CaioPegoraro/ProjetoFinalMic/schematics/schematics.txt

== Emissor primario
https://github.com/CaioPegoraro/ProjetoFinalMic/blob/master/schematics/emissor_primario.png

(20/01/2017)
- Adicionado ligações do emissor primário

== Receptor primário 
https://github.com/CaioPegoraro/ProjetoFinalMic/blob/master/schematics/receptor_primario.PNG

(20/01/2017)
- Adicionado ligações do receptor primário

== Receptor secundário
https://github.com/CaioPegoraro/ProjetoFinalMic/blob/master/schematics/receptor_secundario2.png

(01/02/2017)
- Adicionado esquemático inicial do receptor secundário

(09/02/2017)
- Esquemático do receptor secundário atualizado
