CaioPegoraro/ProjetoFinalMic/imagens/Capture.PNG

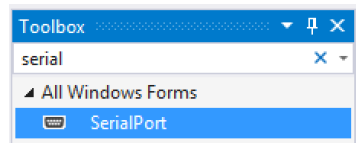
imagens/Capture.PNG
