CaioPegoraro/ProjetoFinalMic/imagens/Rover 2.JPG

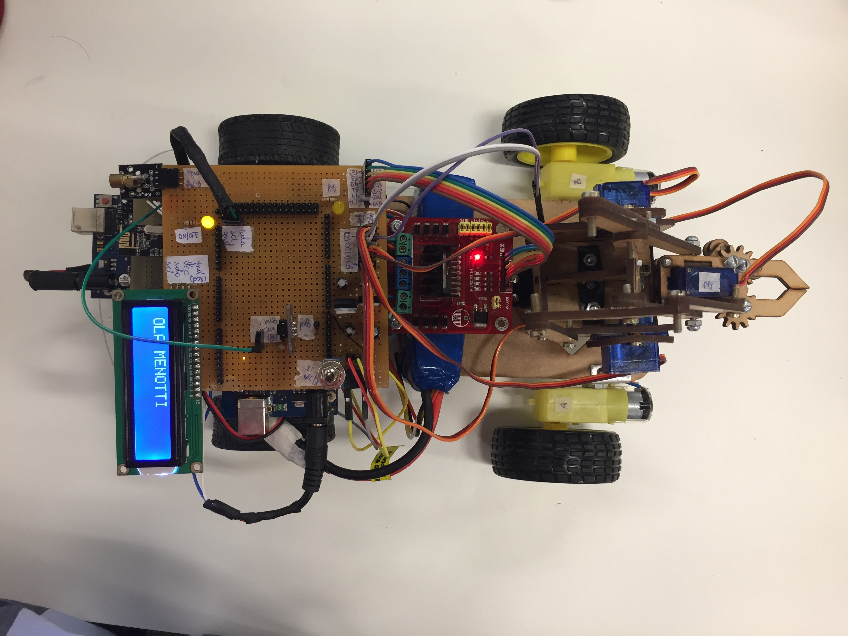
imagens/Rover 2.JPG
