CaioPegoraro/ProjetoFinalMic/imagens/Rover 3.JPG

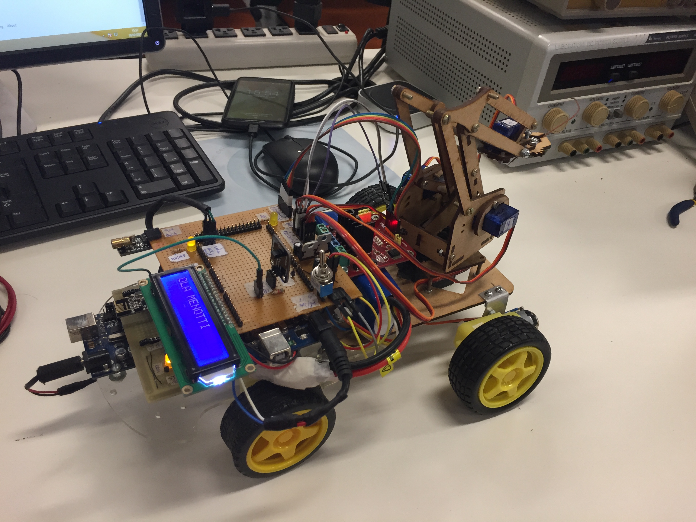
imagens/Rover 3.JPG
