CaioPegoraro/ProjetoFinalMic/imagens/Rover.JPG

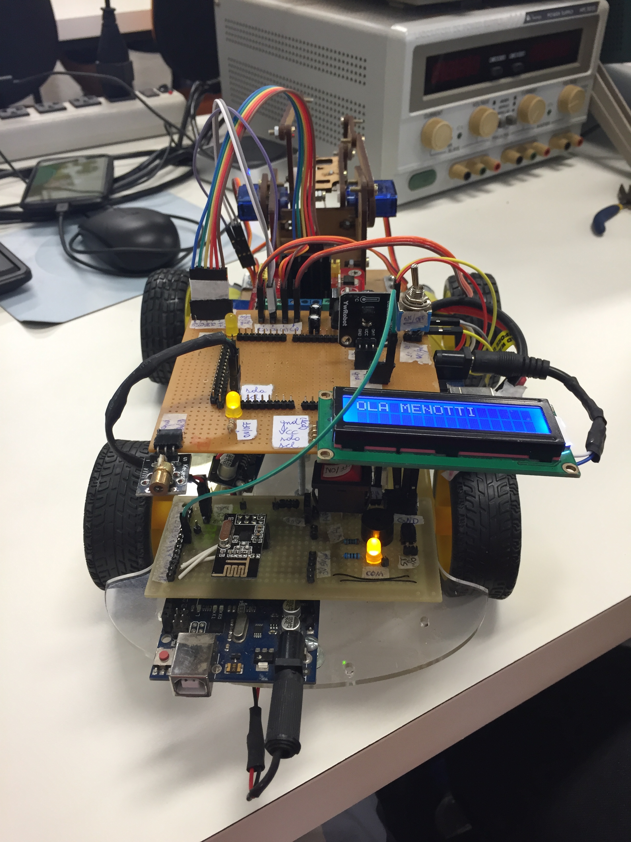
imagens/Rover.JPG
