CaioPegoraro/ProjetoFinalMic/imagens/Sensor Distância.jpg

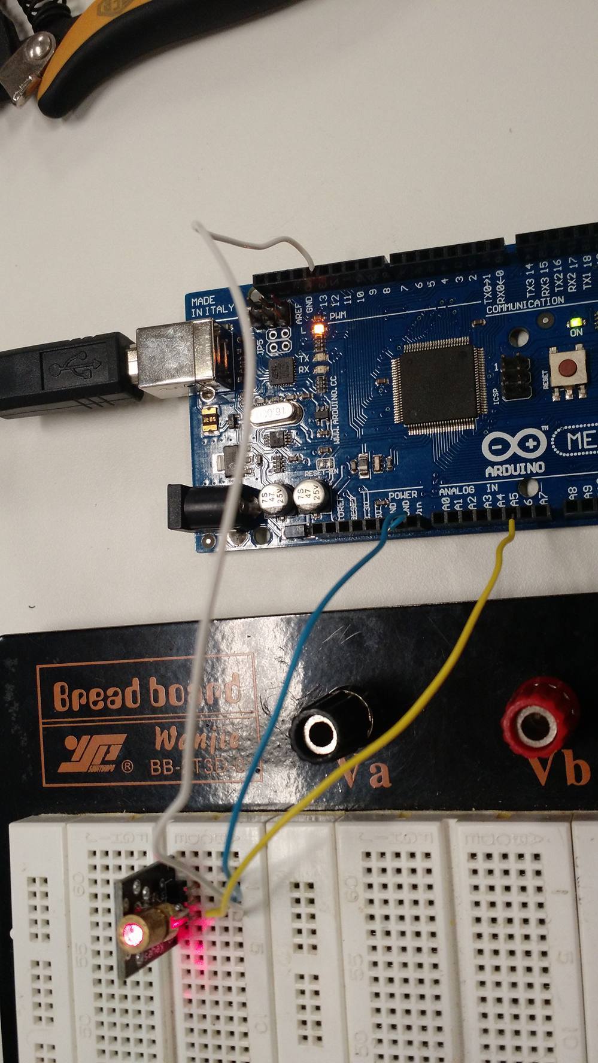
imagens/Sensor Distância.jpg
