CaioPegoraro/ProjetoFinalMic/imagens/Sensor temperatura.jpg

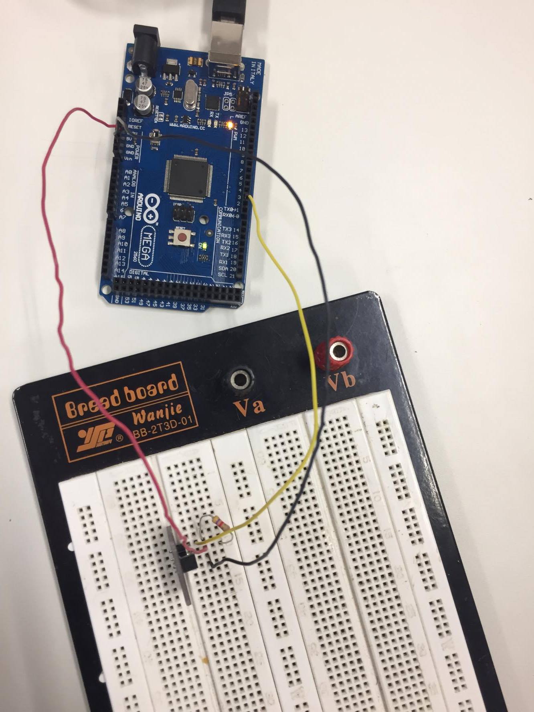
imagens/Sensor temperatura.jpg
