CaioPegoraro/ProjetoFinalMic/RoverPainelDeControle/display.PNG

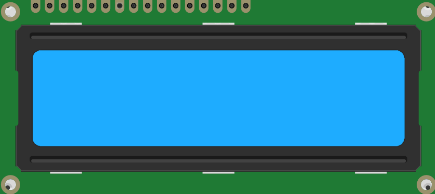
RoverPainelDeControle/display.PNG
