CaioPegoraro/ProjetoFinalMic/RoverPainelDeControle/VantPainelDeControle/Resources/setaDir.png

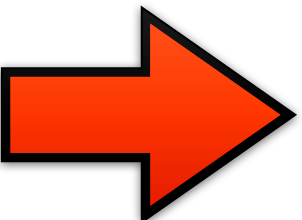
RoverPainelDeControle/VantPainelDeControle/Resources/setaDir.png
