CaioPegoraro/ProjetoFinalMic/algoritmos parciais/ic2parte1 - Cópia/ic2parteLcd/ic2parteLcd.ino

#include <Wire.h>
#include <LiquidCrystal_I2C.h>

// Inicializa o display no endereco 0x27
LiquidCrystal_I2C lcd(0x27,2,1,0,4,5,6,7,3, POSITIVE);

int x;
// function that executes whenever data is received from master
// this function is registered as an event, see setup()
void receiveEvent(int howMany) {
  while (1 < Wire.available()) { // loop through all but the last
    char c = Wire.read(); // receive byte as a character
    Serial.print(c);         // print the character
  }
  x = Wire.read();    // receive byte as an integer
  Serial.println(x);         // print the integer
}

void setup() {
  Wire.begin(8);                // join i2c bus with address #8
  Wire.onReceive(receiveEvent); // register event

  lcd.begin (16,2);
  
  Serial.begin(9600);           // start serial for output
}

void loop() {
  delay(100);

  lcd.setBacklight(HIGH);
  lcd.setCursor(0,0);
  lcd.print("Arduino e Cia !!");
  lcd.setCursor(0,1);
  lcd.print(x);
  delay(1000);
}
