CaioPegoraro/ProjetoFinalMic/(commit log)

2017-01-20 adicionado schematics dos circuitos construidos.
2017-01-20 esquema de ligação do receptor secundario.
2017-01-20 imagem da arquitetura de comunicacao
2017-01-20 Painel de controle (deve ter dado erro na tentativa anterior).
    [VantPainelDeControle.sdf]
2017-01-25 Sketch do sensor de temperatura
2017-02-01 Teste dos sensores de temperatura e distância.
2017-02-02 - painel de controle: versao beta com os controles do servomotor e motores dc, do laser e display lcd -receptor primario: complementacao para operar o display e novos comandos -receptor secundario: i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
2017-02-09 Update schematics.txt
    Atualização do changelog...
2017-02-10 Correções no painel de controle (nas funções de operação do display lcd). e adição da tabela de comandos (códigos e descrição).
    [tabela comandos.xlsx]
2017-02-10 - codigo do sensor de temperatura - implementacao da leitura da temperatura pelo painel de controle - correcoes de problemas gerais (eletricos)
    [tabela comandos.xlsx]
2017-02-15 Update README.md
    adição de algumas informações e referências ao projeto.
